gannaramu/SSS3/docs/SSS3 Rev 1 Schematics.pdf

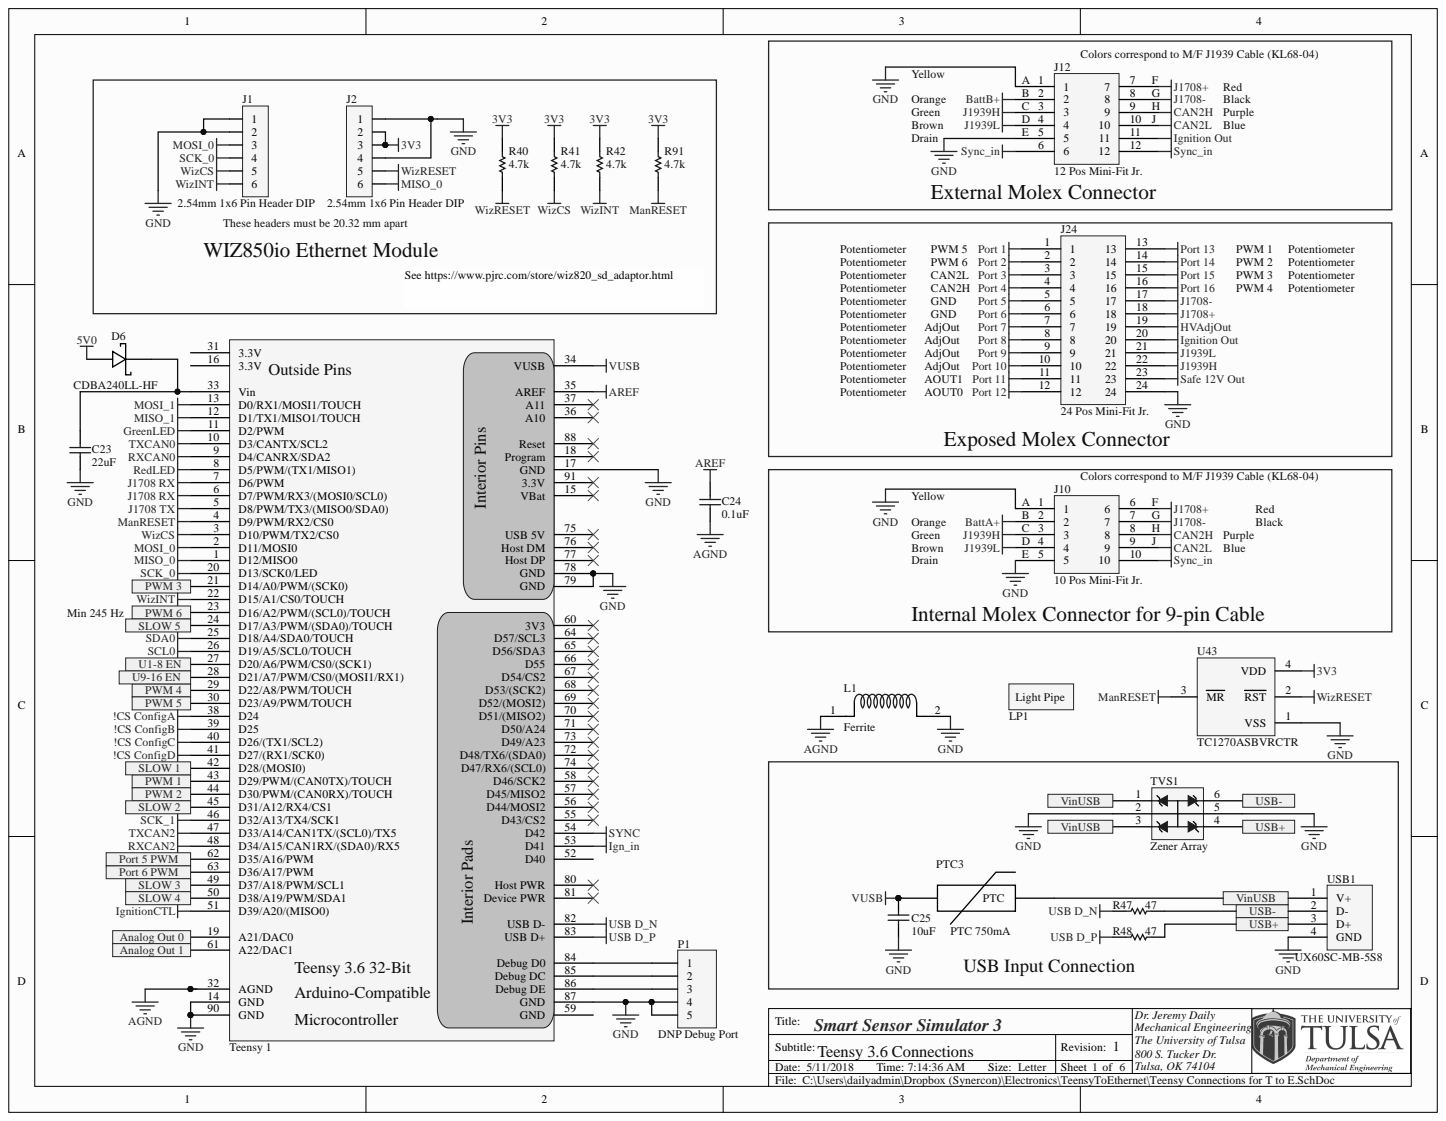
[picture p3: page 1]

12 Pos Mini-Fit Jr.

These headers must be 20.32 mm apart
WIZ850io Ethernet Module

See https://www.pjrc.com/store/wiz820_sd_adaptor.html

24 Pos Mini-Fit Jr.

Interior Pins Interior Pads

10 Pos Mini-Fit Jr.

Internal Molex Connector for 9-pin Cable

Title: Smart Sensor Simulator 3 | Dr. Jeremy Daily Mechanical Engineering The University of Tulsa 800 S. Tucker Dr. Tulsa, OK 74104

Teensy 3.6 Connections Subtitle: | 1 Revision:

Date: 5/11/2018 Time: 7:14:36 AM Size: Letter | Sheet of

C:\Users\dailyadmin\Dropbox (Synercon)\Electronics\TeensyToEthernet\Teensy Connections for T to E.SchDoc

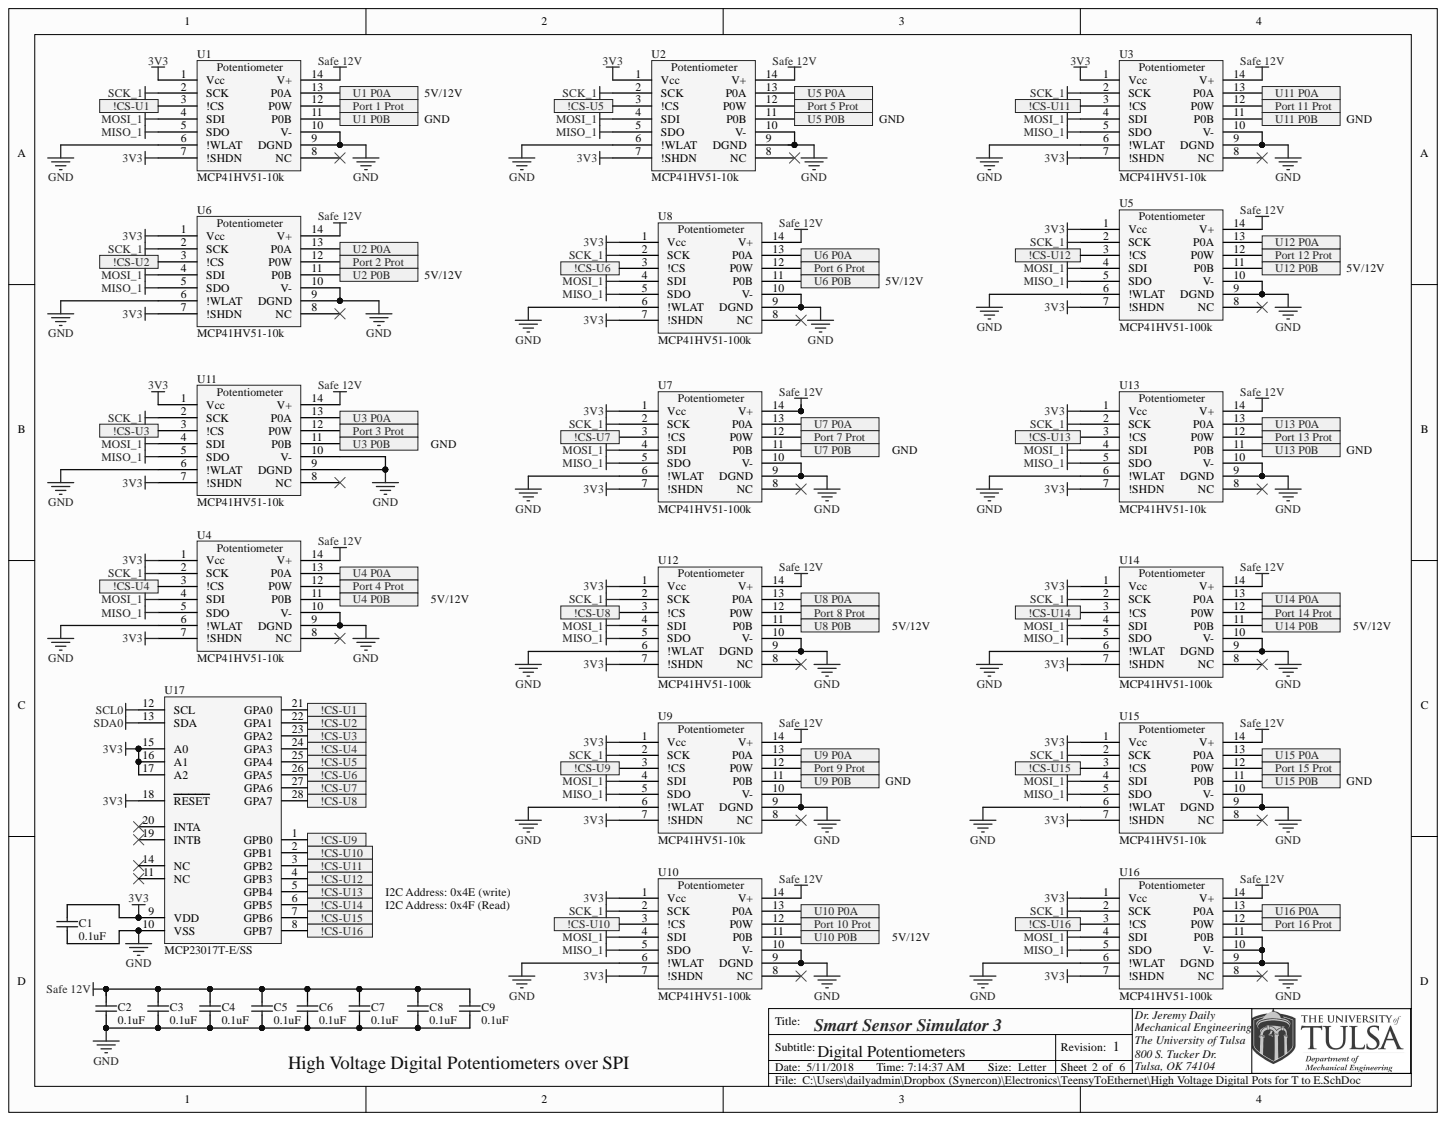
[picture p4: page 2]

Title: Smart Sensor Simulator 3 | Dr. Jeremy Daily 800 S. Tucker Dr.

Digital Potentiometers | 1

High Voltage Digital Potentiometers over SPI

C:\Users\dailyadmin\Dropbox (Synercon)\Electronics\TeensyToEthernet\High Voltage Digital Pots for T to E.SchDoc

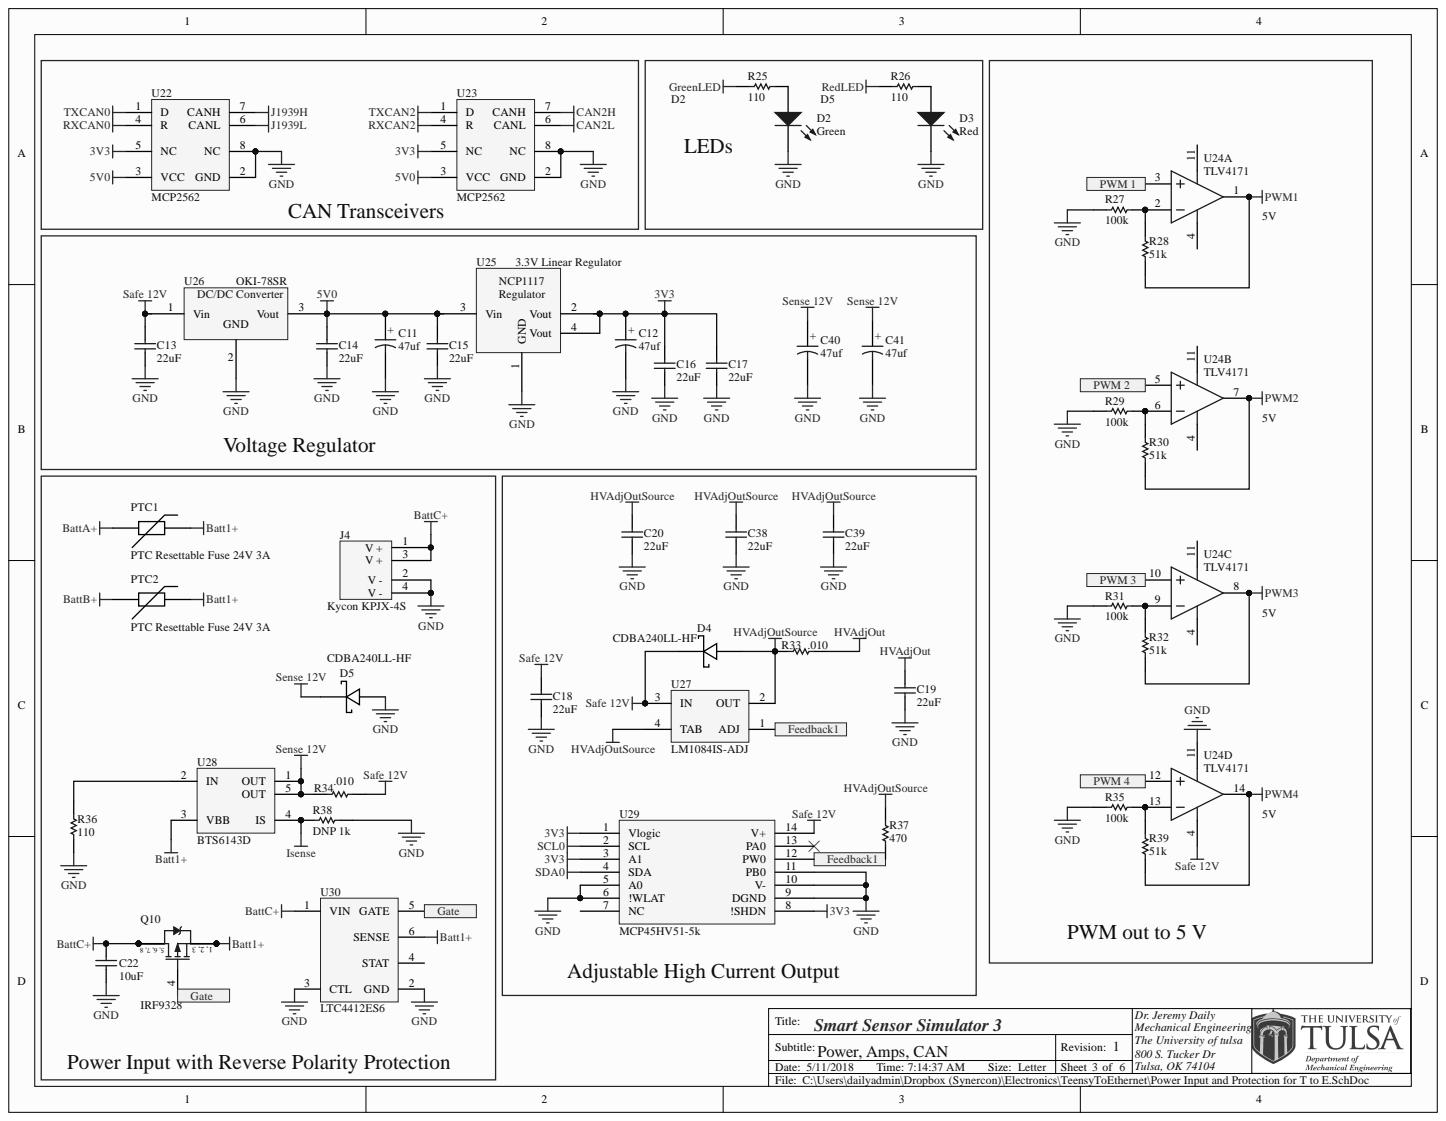
[picture p5: page 3]

Adjustable High Current Output

The University of tulsa
800 S. Tucker Dr

C:\Users\dailyadmin\Dropbox (Synercon)\Electronics\TeensyToEthernet\Power Input and Protection for T to E.SchDoc

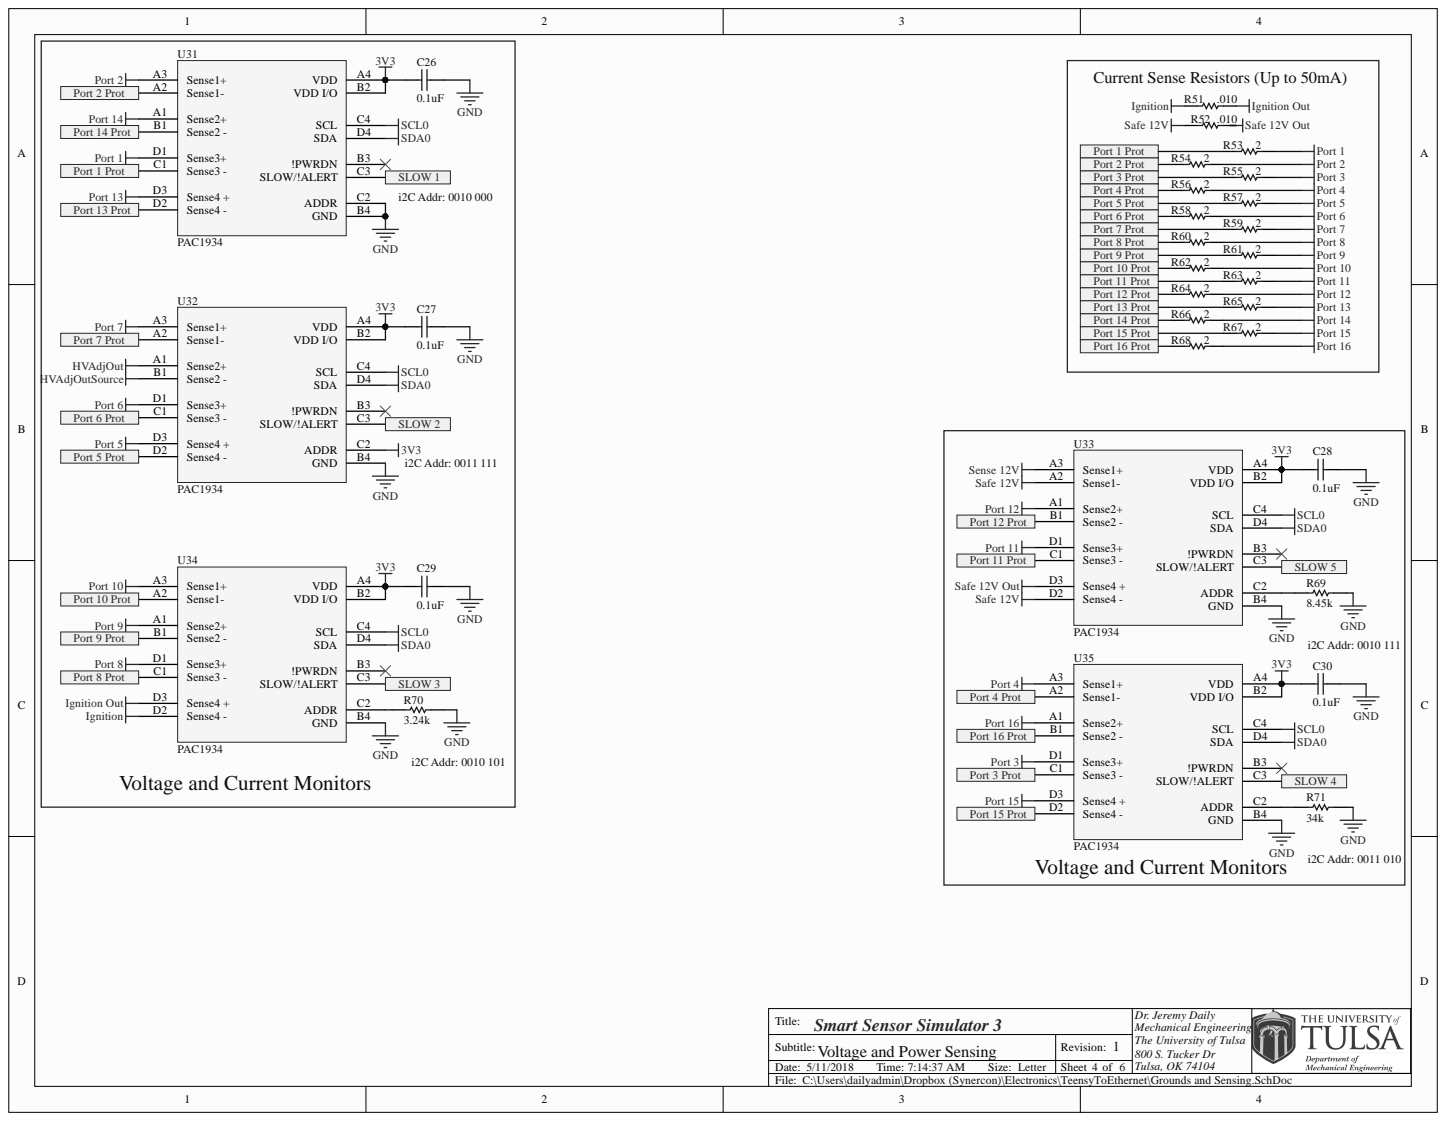
[picture p6: page 4]

U31 PAC1934 Sense1+
Port 13 Prot Port 1 Port 1 Prot Port 2 Port 2 Prot Port 14 Port 14 Prot Port 7 Port 7 Prot HVAdjOut

Current Sense Resistors (Up to 50mA)

Port 1 Prot Port 2 Prot Port 3 Prot Port 4 Prot Port 5 Prot Port 6 Prot Port 7 Prot Port 8 Prot

Port 1 Port 2 Port 3 Port 4 Port 6 Port 7 Port 8 Port 5

Port 9 Prot Port 10 Prot Port 11 Prot Port 12 Prot Port 13 Prot Port 14 Prot Port 15 Prot Port 16 Prot

Port 8 Prot Port 5 Port 5 Prot Port 6 Port 6 Prot

Port 10
Port 10 Prot Port 9 Port 9 Prot

Port 15 Prot Port 16 Port 16 Prot Port 3 Port 3 Prot Port 4 Port 4 Prot

Voltage and Current Monitors

Title: | D r. Jeremy Daily 800 S. Tucker D r Tulsa, O K 74104

Smart Sensor Simulator 3 Voltage and Power Sensing

Subtitle: Date: File:
5/11/2018 Time: 7:14:37 M Letter | Sheet of

C:\Users\dailyadmin\Dropbox (Synercon)\Electronics\TeensyToEthernet\Grounds and Sensing.SchDoc

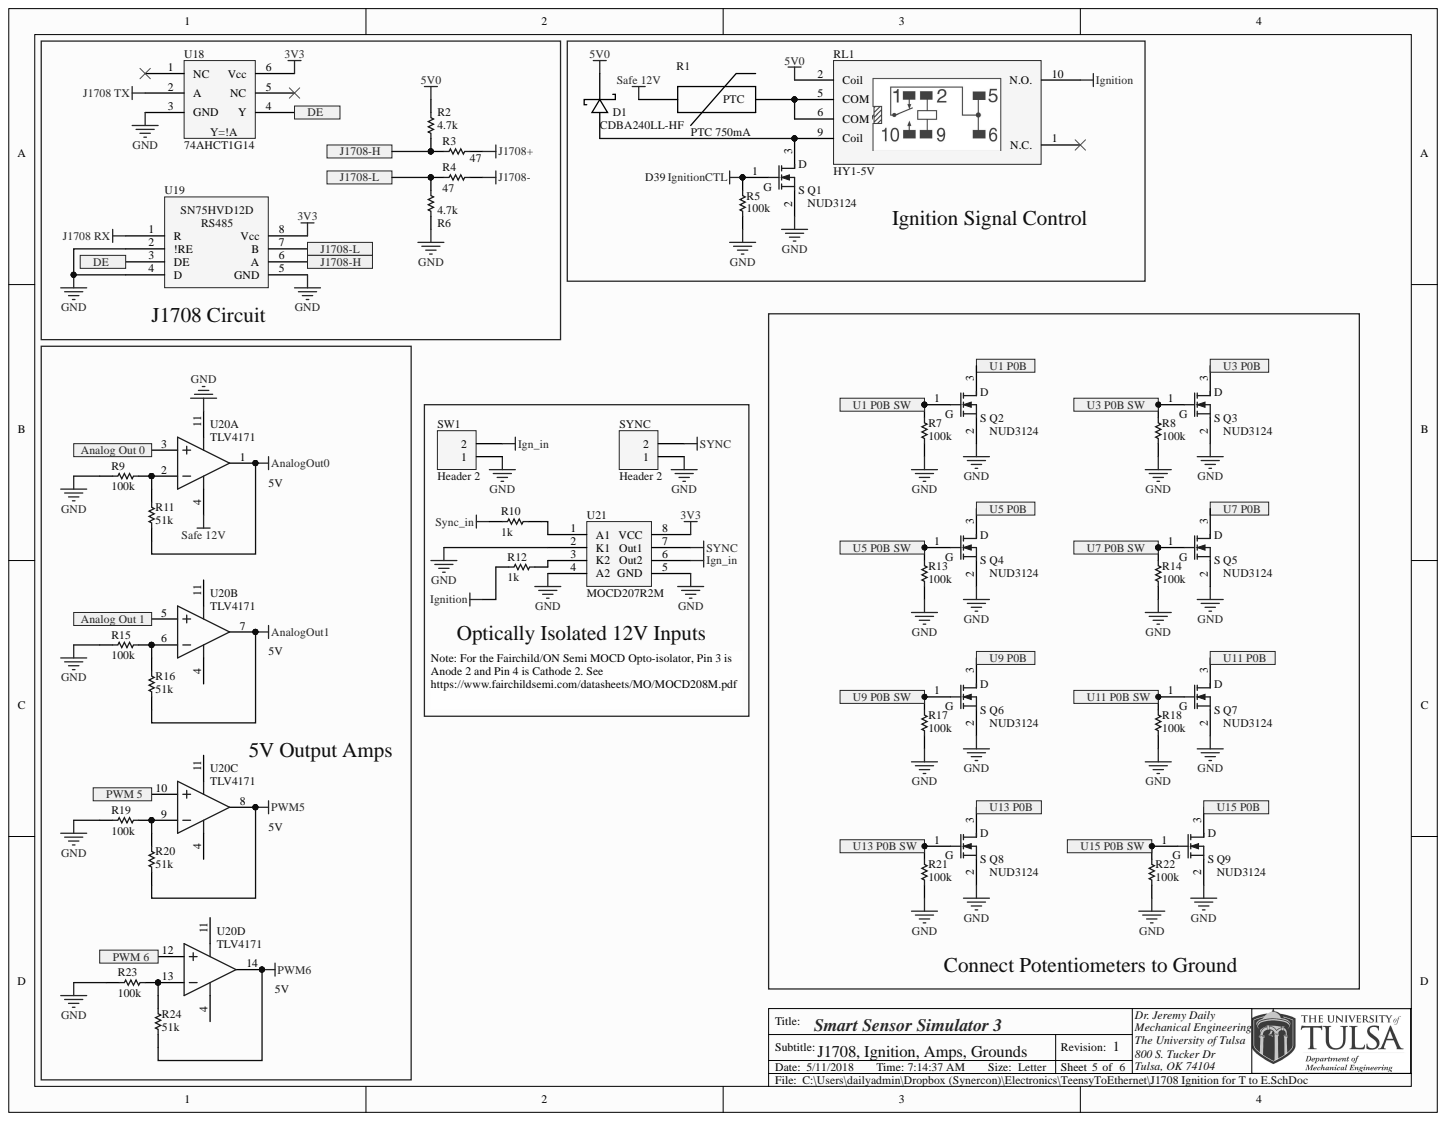
[picture p7: page 5]

Note: For the Fairchild/ON Semi MOCD Opto-isolator, Pin 3 is
Anode 2 and Pin 4 is Cathode 2. See
https://www.fairchildsemi.com/datasheets/MO/MOCD208M.pdf

GND
Connect Potentiometers to Ground

Title: Smart Sensor Simulator 3 | Dr. Jeremy Daily 800 S. Tucker Dr

J1708, Ignition, Amps, Grounds | 1

C:\Users\dailyadmin\Dropbox (Synercon)\Electronics\TeensyToEthernet\J1708 Ignition for T to E.SchDoc

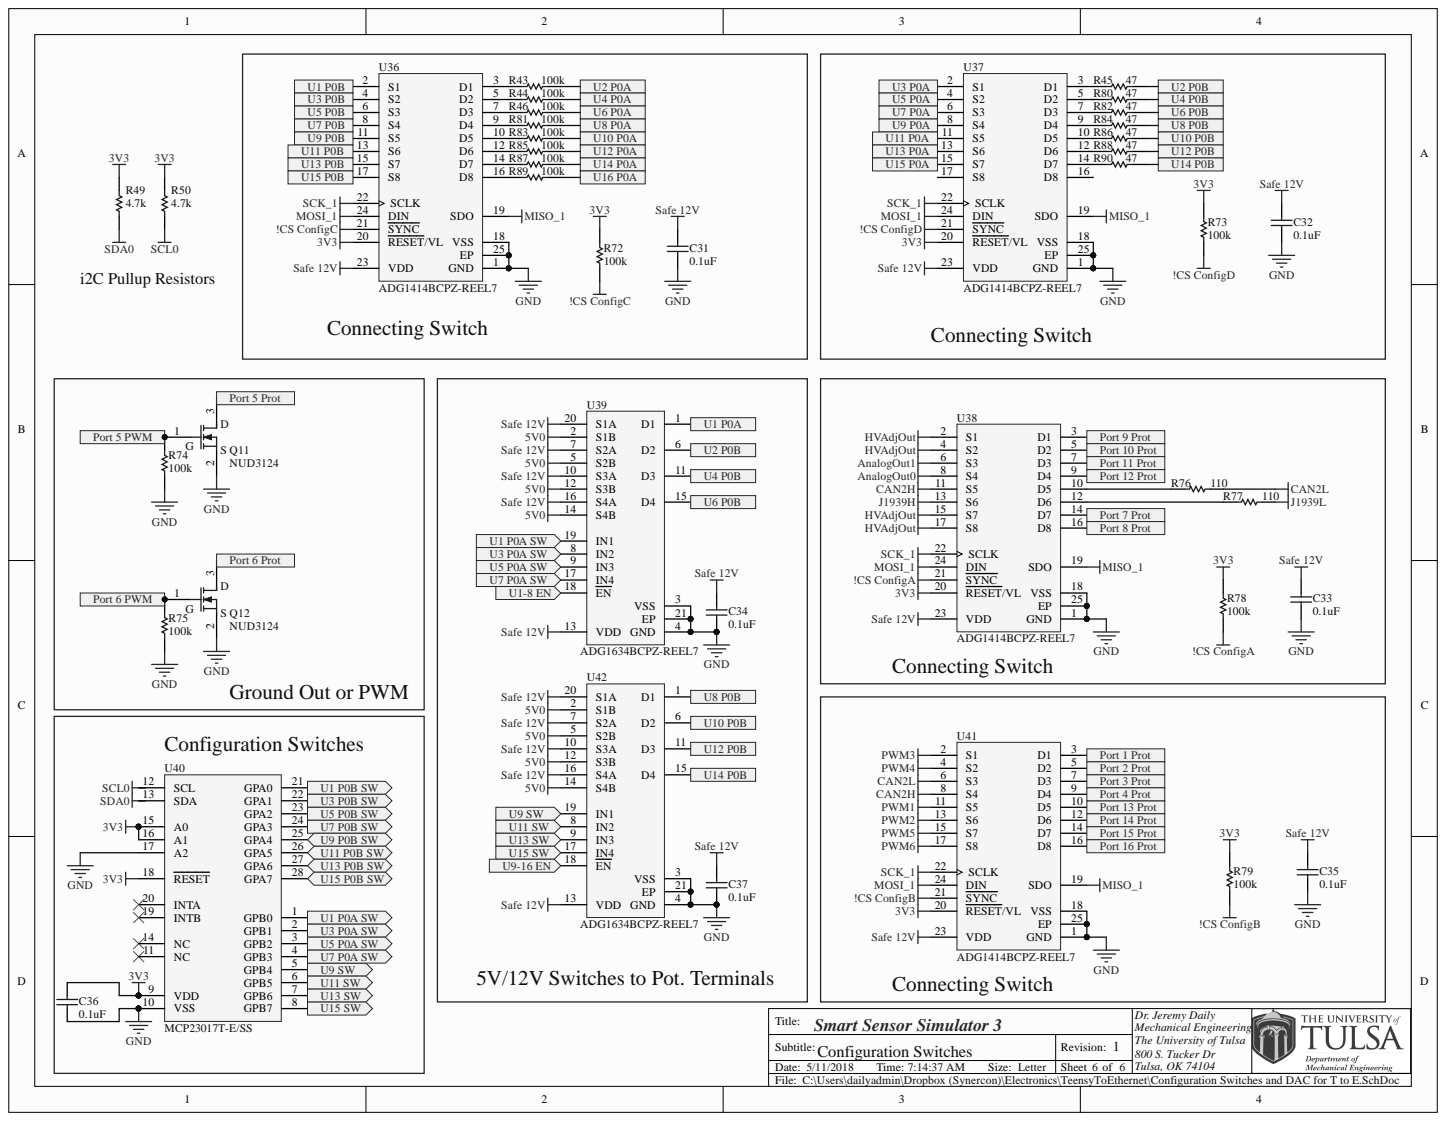
[picture p8: page 6]

Connecting Switch
Port 5 Prot Port 6 Prot
Port 6 PWM Port 5 PWM

Port 9 Prot Port 10 Prot Port 11 Prot Port 12 Prot

Ground Out or PW

Port 1 Prot Port 2 Prot Port 3 Prot Port 4 Prot

Subtitle: Date: File: Configuration Switches
5/11/2018 Time: 7:14:37 M Letter | Sheet of

C:\Users\dailyadmin\Dropbox (Synercon)\Electronics\TeensyToEthernet\Configuration S
