gannaramu/SSS3/(commit log)

2020-10-20 initial upload
    [HID Message Data Structures.xlsx, SSS2 Settings Register for CAT BXS.csv]
2020-10-21 Added Ethernet and Relay
2021-09-14 Working CAN with Relay and LED
2021-09-20 PWM working code
2021-09-20 Updated board defines
2021-09-20 Working PWM with SSS2-GUI PlatformIO format
2021-09-23 React based Front end for Teensy
2021-09-23 GET for PWM Working
    Updated the React GUI
2021-09-26 Working PWM excluding switches
2021-09-28 Convert PWM to child based
